pmarks-net/everclamp/README.md

Content for https://pmarks-net.github.io/everclamp/
