pmarks-net/everclamp/bundle_scad/demo_unthreaded.stl

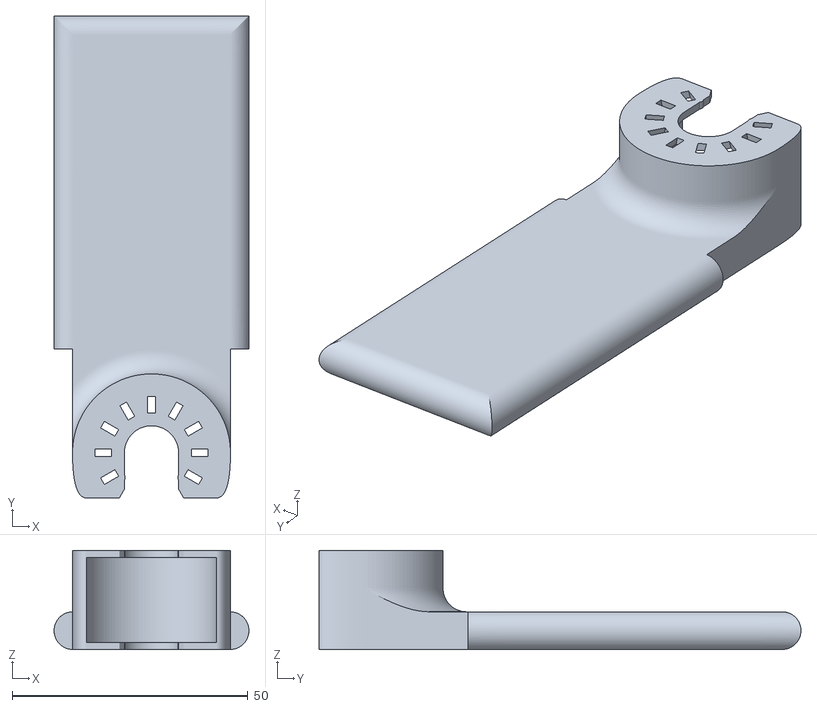
[picture p4: CAD file, 2023-06-24]
bundle_scad/demo_unthreaded.stl
41.3 x 102.2 x 21.0
