pmarks-net/everclamp/(list of files, cad)

Other CAD files:
calibration_holes.scad
everclamp_example_array.scad
