pmarks-net/everclamp/(threads)

Thread 1 (2023-06-20):

Discussion: easiest way to print M6 threads?

pmarks-net, 2023-06-20:
Under the current https://everclamp.org/#calibration procedure, model creators need to produce multiple STL files with different scaling values.  This is pretty tedious, and it would be nice to find a better solution.  I'm leaving this issue open for general discussion.
