pmarks-net/everclamp/(commit log)

2023-06-24 Add bundle_scad.py and a thread-cutting demo.
    [bosl2_builtins_test.scad, demo_unthreaded.stl, everclamp_thread_cutter.scad]
2023-06-24 Fix some bugs in bundle_scad
    [everclamp_thread_cutter.scad]
2023-06-24 Prompt to install numpy-stl if needed.
2023-06-24 Clean up calibration references
    [calibration_bolts.scad, calibration_holes.scad, everclamp_example_array.scad, everclamp_thread_cutter.scad, m6_thumbscrew.scad]
